maartenboz/ESP32-Room-Sensor-AI/bom/KiCad_MCP_Test_BOM.csv

References | Value | Footprint | Manufacturer | MPN | Datasheet | Description | Quantity
C1-C3,C5,C10,C12-C14 | 100n | Capacitor_SMD:C_0603_1608Metric | Yageo | CC0603KRX7R9BB104 | https://www.yageo.com/upload/media/product/productsearch/datasheet/mlcc/UPY-GPHC_X7R_6.3V-to-50V_18.pdf |  | 8
C4 | 10u | Capacitor_SMD:C_0805_2012Metric | Yageo | CC0805MKX5R5BB106 | https://www.yageo.com/upload/media/product/productsearch/datasheet/mlcc/UPY-GPHC_X7R_6.3V-to-50V_18.pdf |  | 1
C6 | 100n BST | Capacitor_SMD:C_0603_1608Metric | Yageo | CC0603KRX7R9BB104 | https://www.yageo.com/upload/media/product/productsearch/datasheet/mlcc/UPY-GPHC_X7R_6.3V-to-50V_18.pdf |  | 1
C7-C9 | 22u | Capacitor_SMD:C_0805_2012Metric | Murata | GRM21BR61A226ME44L | https://search.murata.co.jp/Ceramy/image/img/A01X/G101/ENG/GRM21BR61A226ME44-01.pdf |  | 3
C11 | 1u | Capacitor_SMD:C_0603_1608Metric | Yageo | CC0603KRX7R7BB105 | https://www.yageo.com/upload/media/product/productsearch/datasheet/mlcc/UPY-GPHC_X7R_6.3V-to-50V_18.pdf |  | 1
D1 | PESD5V0S1UL | Diode_SMD:D_SOD-882 | Nexperia | PESD5V0S1UL,315 | https://assets.nexperia.com/documents/data-sheet/PESD5V0S1UL.pdf |  | 1
D2 | USER_LED1 RED | LED_SMD:LED_0603_1608Metric | Kingbright | APT1608LSECK | https://www.kingbrightusa.com/images/catalog/SPEC/APT1608LSECK.pdf |  | 1
D3 | USER_LED2 YELLOW | LED_SMD:LED_0603_1608Metric | Kingbright | APT1608SYCK | https://www.kingbrightusa.com/images/catalog/SPEC/APT1608SYCK.pdf |  | 1
D4 | USB_RX GREEN | LED_SMD:LED_0603_1608Metric | Kingbright | APT1608SGC | https://www.kingbrightusa.com/images/catalog/SPEC/APT1608SGC.pdf |  | 1
D5 | USB_TX YELLOW | LED_SMD:LED_0603_1608Metric | Kingbright | APT1608SYCK | https://www.kingbrightusa.com/images/catalog/SPEC/APT1608SYCK.pdf |  | 1
D6 | PWR GREEN | LED_SMD:LED_0603_1608Metric | Kingbright | APT1608SGC | https://www.kingbrightusa.com/images/catalog/SPEC/APT1608SGC.pdf |  | 1
F1 | 1206L050/16WR | Fuse:Fuse_1206_3216Metric | Littelfuse | 1206L050/16WR | https://www.littelfuse.com/media?resourcetype=datasheets&itemid=6f07b5a6-cb36-452d-8a6c-93703eea1f9a |  | 1
J1 | USB4105-GF-A | Connector_USB:USB_C_Receptacle_GCT_USB4105-xx-A_16P_TopMnt_Horizontal | GCT | USB4105-GF-A | https://gct.co/connector/usb4105 |  | 1
L1 | 4.7uH XAL4020-472MEB | Inductor_SMD:L_Coilcraft_XAL4020-XXX | Coilcraft | XAL4020-472MEB | https://www.coilcraft.com/getmedia/78a676e0-1f2d-4e32-b142-5bcaab30da12/xal4020.pdf |  | 1
Q1,Q2 | MMBT3904LT1G | Package_TO_SOT_SMD:SOT-23 | onsemi | MMBT3904LT1G | https://www.onsemi.com/pdf/datasheet/mmbt3904lt1-d.pdf |  | 2
R1,R2 | 5.1k | Resistor_SMD:R_0603_1608Metric | Yageo | RC0603FR-075K1L | https://www.yageo.com/upload/media/product/productsearch/datasheet/rchip/PYu-RC_Group_51_RoHS_L_15.pdf |  | 2
R3-R5,R8-R10,R20 | 10k | Resistor_SMD:R_0603_1608Metric | Yageo | RC0603FR-0710KL | https://www.yageo.com/upload/media/product/productsearch/datasheet/rchip/PYu-RC_Group_51_RoHS_L_15.pdf |  | 7
R6,R7 | 0 | Resistor_SMD:R_0603_1608Metric | Yageo | RC0603JR-070RL | https://www.yageo.com/upload/media/product/productsearch/datasheet/rchip/PYu-RC_Group_51_RoHS_L_15.pdf |  | 2
R11,R12,R15 | 2.2k | Resistor_SMD:R_0603_1608Metric | Yageo | RC0603FR-072K2L | https://www.yageo.com/upload/media/product/productsearch/datasheet/rchip/PYu-RC_Group_51_RoHS_L_15.pdf |  | 3
R13,R14,R18,R19 | 1k | Resistor_SMD:R_0603_1608Metric | Yageo | RC0603FR-071KL | https://www.yageo.com/upload/media/product/productsearch/datasheet/rchip/PYu-RC_Group_51_RoHS_L_15.pdf |  | 4
R16,R17 | 4.7k | Resistor_SMD:R_0603_1608Metric | Yageo | RC0603FR-074K7L | https://www.yageo.com/upload/media/product/productsearch/datasheet/rchip/PYu-RC_Group_51_RoHS_L_15.pdf |  | 2
RV1,RV2 | 10k 3314J-1-103E | Potentiometer_SMD:Potentiometer_Bourns_3314J_Vertical | Bourns | 3314J-1-103E | https://www.bourns.com/docs/product-datasheets/3314.pdf |  | 2
SW1 | USER_BTN1 | Button_Switch_SMD:SW_Tactile_SPST_NO_Straight_CK_PTS636Sx25SMTRLFS | C&K | PTS636 SK25 SMTR LFS | https://www.ckswitches.com/media/1479/pts636.pdf |  | 1
SW2 | USER_BTN2 | Button_Switch_SMD:SW_Tactile_SPST_NO_Straight_CK_PTS636Sx25SMTRLFS | C&K | PTS636 SK25 SMTR LFS | https://www.ckswitches.com/media/1479/pts636.pdf |  | 1
SW3 | BOOT | Button_Switch_SMD:SW_Tactile_SPST_NO_Straight_CK_PTS636Sx25SMTRLFS | C&K | PTS636 SK25 SMTR LFS | https://www.ckswitches.com/media/1479/pts636.pdf |  | 1
SW4 | RESET | Button_Switch_SMD:SW_Tactile_SPST_NO_Straight_CK_PTS636Sx25SMTRLFS | C&K | PTS636 SK25 SMTR LFS | https://www.ckswitches.com/media/1479/pts636.pdf |  | 1
TP1 | 5V | TestPoint:TestPoint_Pad_D1.0mm | Keystone Electronics | 5015 |  |  | 1
TP2 | 3V3 | TestPoint:TestPoint_Pad_D1.0mm | Keystone Electronics | 5015 |  |  | 1
TP3 | GND | TestPoint:TestPoint_Pad_D1.0mm | Keystone Electronics | 5015 |  |  | 1
TP4 | TXD0 | TestPoint:TestPoint_Pad_D1.0mm | Keystone Electronics | 5015 |  |  | 1
TP5 | RXD0 | TestPoint:TestPoint_Pad_D1.0mm | Keystone Electronics | 5015 |  |  | 1
TP6 | EN | TestPoint:TestPoint_Pad_D1.0mm | Keystone Electronics | 5015 |  |  | 1
TP7 | GPIO0 | TestPoint:TestPoint_Pad_D1.0mm | Keystone Electronics | 5015 |  |  | 1
TP8 | SDA | TestPoint:TestPoint_Pad_D1.0mm | Keystone Electronics | 5015 |  |  | 1
TP9 | SCL | TestPoint:TestPoint_Pad_D1.0mm | Keystone Electronics | 5015 |  |  | 1
U1 | USBLC6-2SC6 | Package_TO_SOT_SMD:SOT-23-6 | STMicroelectronics | USBLC6-2SC6 | https://www.st.com/resource/en/datasheet/usblc6-2.pdf |  | 1
U2 | FT231XS-R | Package_SO:SSOP-20_3.9x8.7mm_P0.635mm | FTDI | FT231XS-R | https://ftdichip.com/wp-content/uploads/2021/10/DS_FT231X.pdf |  | 1
U3 | AP63203WU-7 | Package_TO_SOT_SMD:TSOT-23-6 | Diodes Incorporated | AP63203WU-7 | https://www.diodes.com/datasheet/download/AP63200-AP63201-AP63203-AP63205.pdf |  | 1
U4 | ESP32-S3-WROOM-1-N8 | RF_Module:ESP32-S3-WROOM-1 | Espressif Systems | ESP32-S3-WROOM-1-N8 | https://documentation.espressif.com/esp32-s3-wroom-1_wroom-1u_datasheet_en.pdf |  | 1
U5 | SHT40-AD1B-R2 | Sensor_Humidity:Sensirion_DFN-4_1.5x1.5mm_P0.8mm_SHT4x_NoCentralPad | Sensirion | SHT40-AD1B-R2 | https://sensirion.com/media/documents/33FD6951/67EB9032/HT_DS_Datasheet_SHT4x.pdf |  | 1
