maartenboz/ESP32-Room-Sensor-AI/docs/pdf/ESP32-Room-Sensor-Schematic.pdf

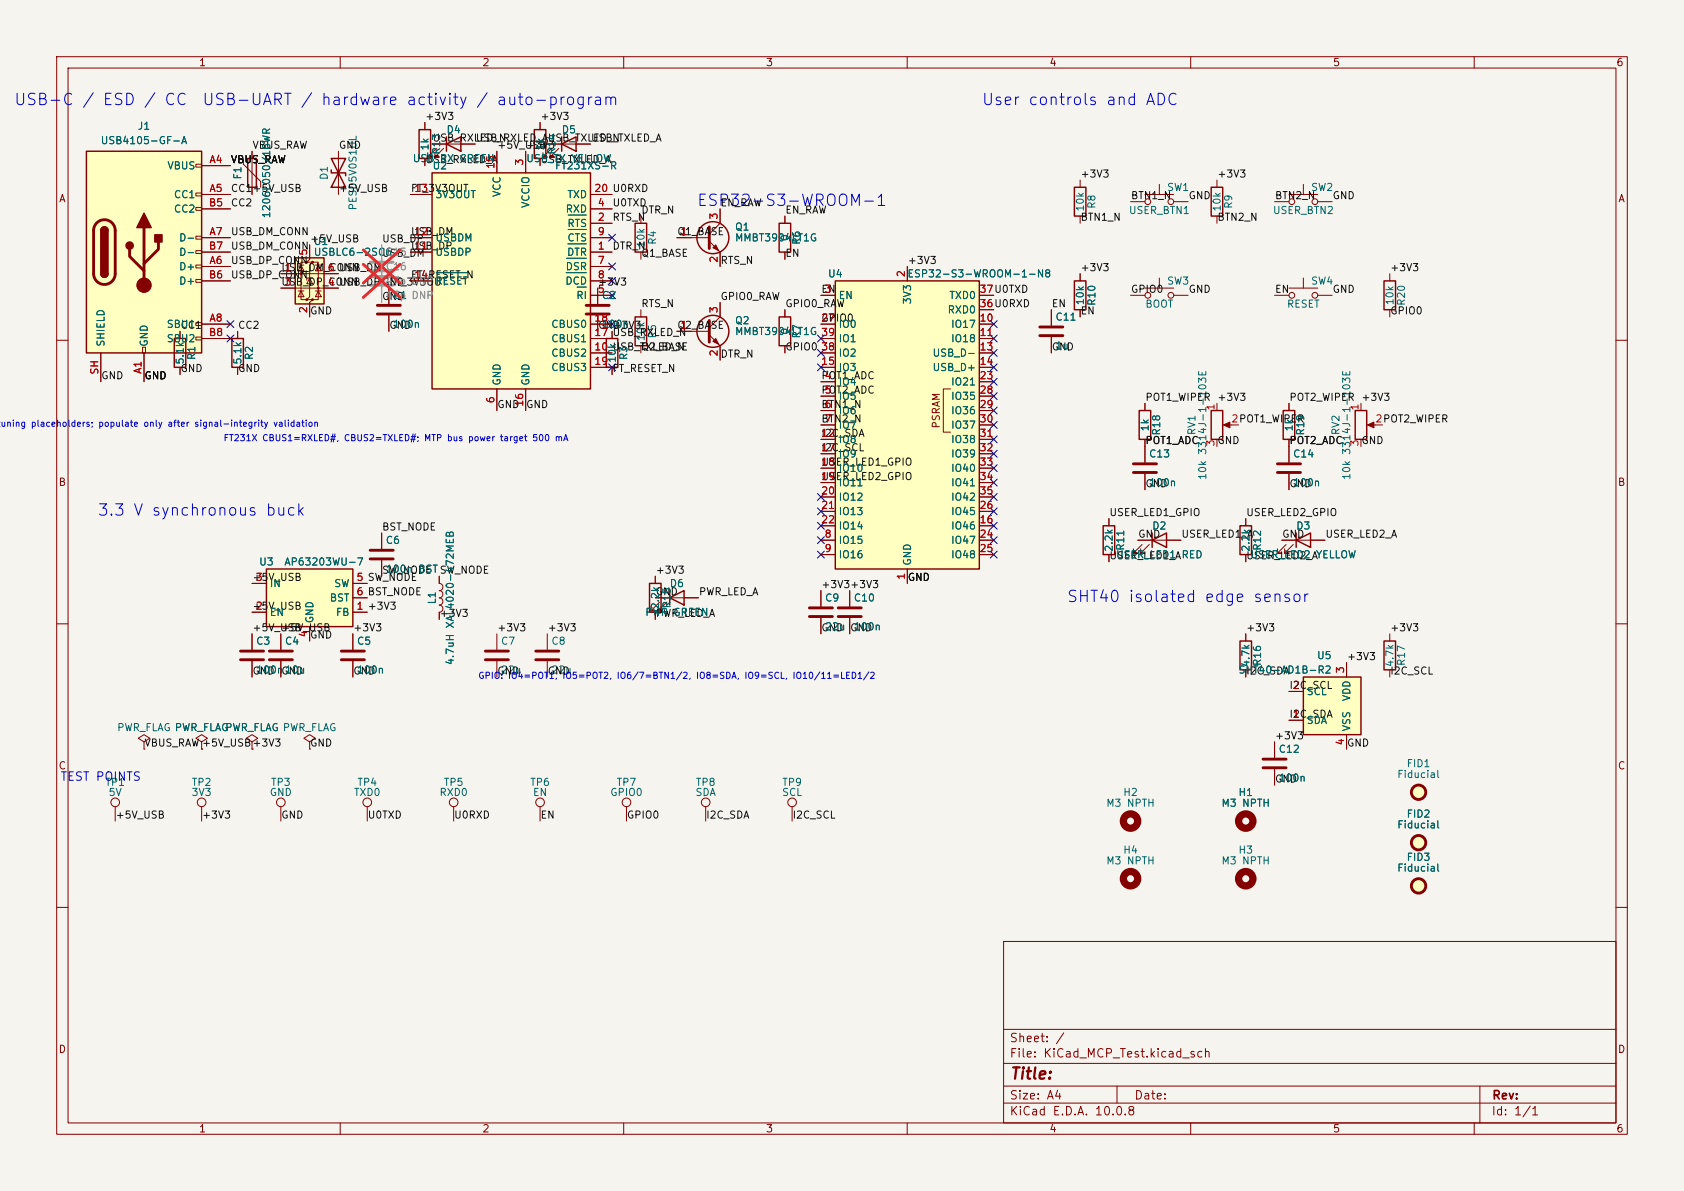
[picture p4: page 1]

GPIO: IO4=POT1, IO5=POT2, IO6/7=BTN1/2, IO8=SDA, IO9=SCL, IO10/11=LED1/2 USB-UART / hardware activity / auto-program

6 DSR 7 DCD 8 CTS 9 CBUS2 10 USBDP 11 USBDM 12

C15/C16 are DNP USB tuning placeholders; populate only after signal-integrity validation

Size: A4 | Rev:
KiCad E.D.A. 10.0.8 | Id: 1/1
