maartenboz/ESP32-Room-Sensor-AI/docs/pdf/ESP32-Room-Sensor-PCB.pdf

L1 | USB-C
RX | TX | PWR

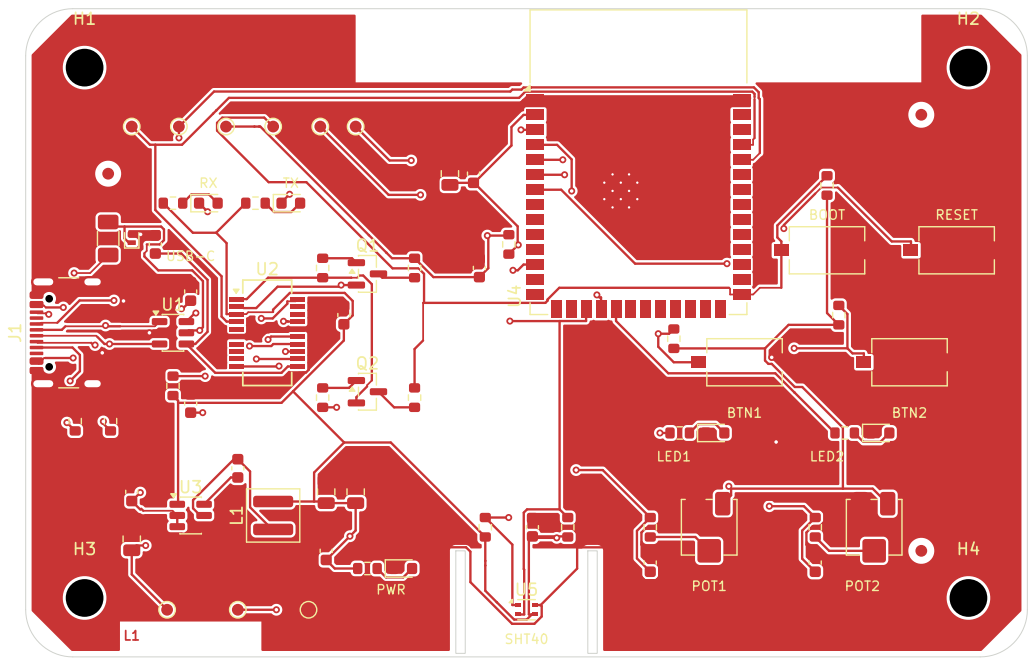
[picture p5: page 1]
SHT40; LED1POT1BTN1; BOOT LED2POT2 BTN2 RESET Q1Q2 J1

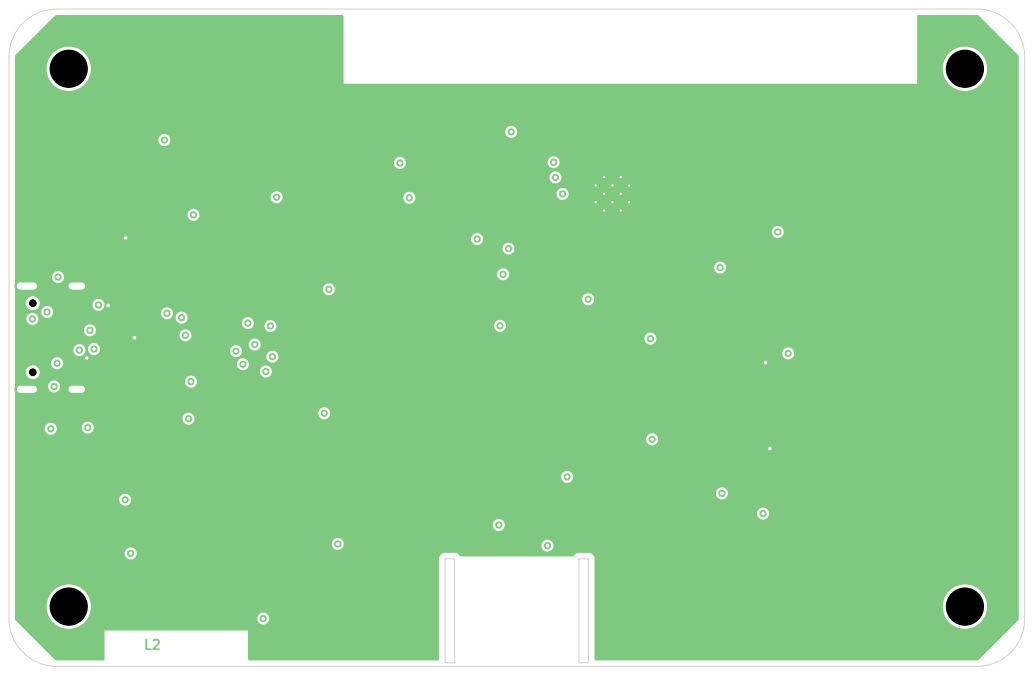
[picture p6: page 2]

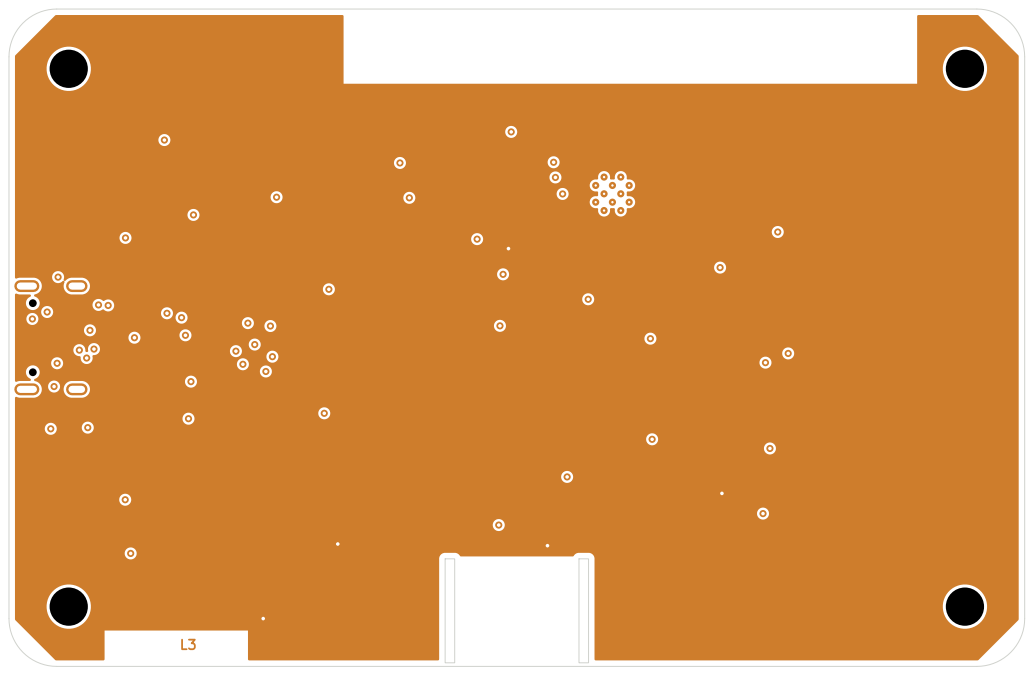
[picture p7: page 3]

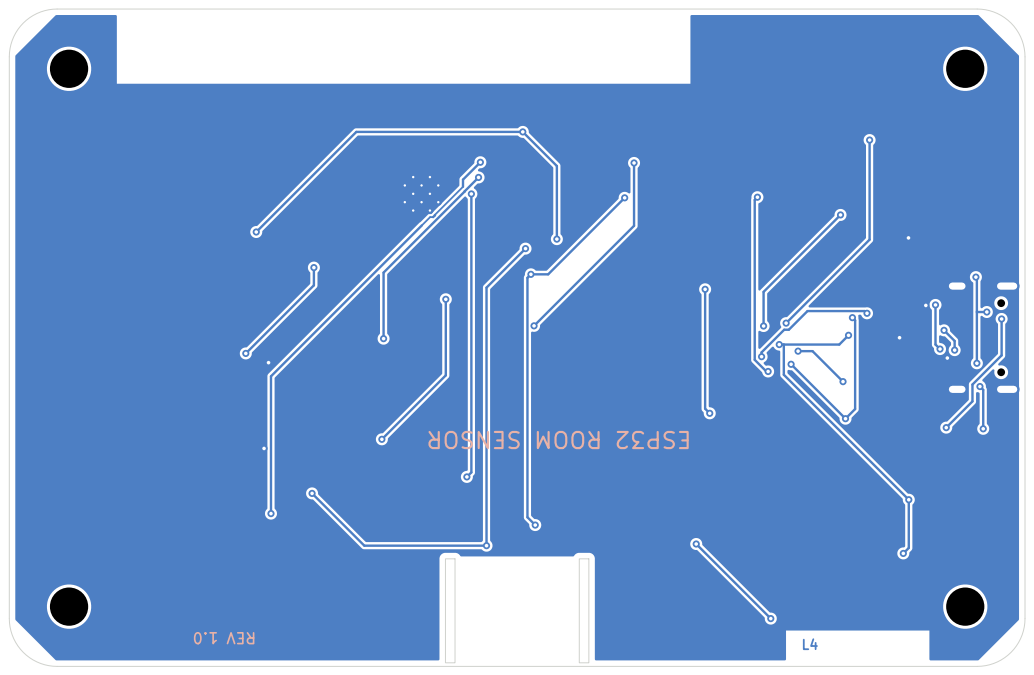
[picture p8: page 4]
REV; SENSOR; ROOM; ESP32
