maartenboz/ESP32-Room-Sensor-AI/KiCad_MCP_Test.kicad_pcb

## KiCad design KiCad_MCP_Test.kicad_pcb (2026-11-09)

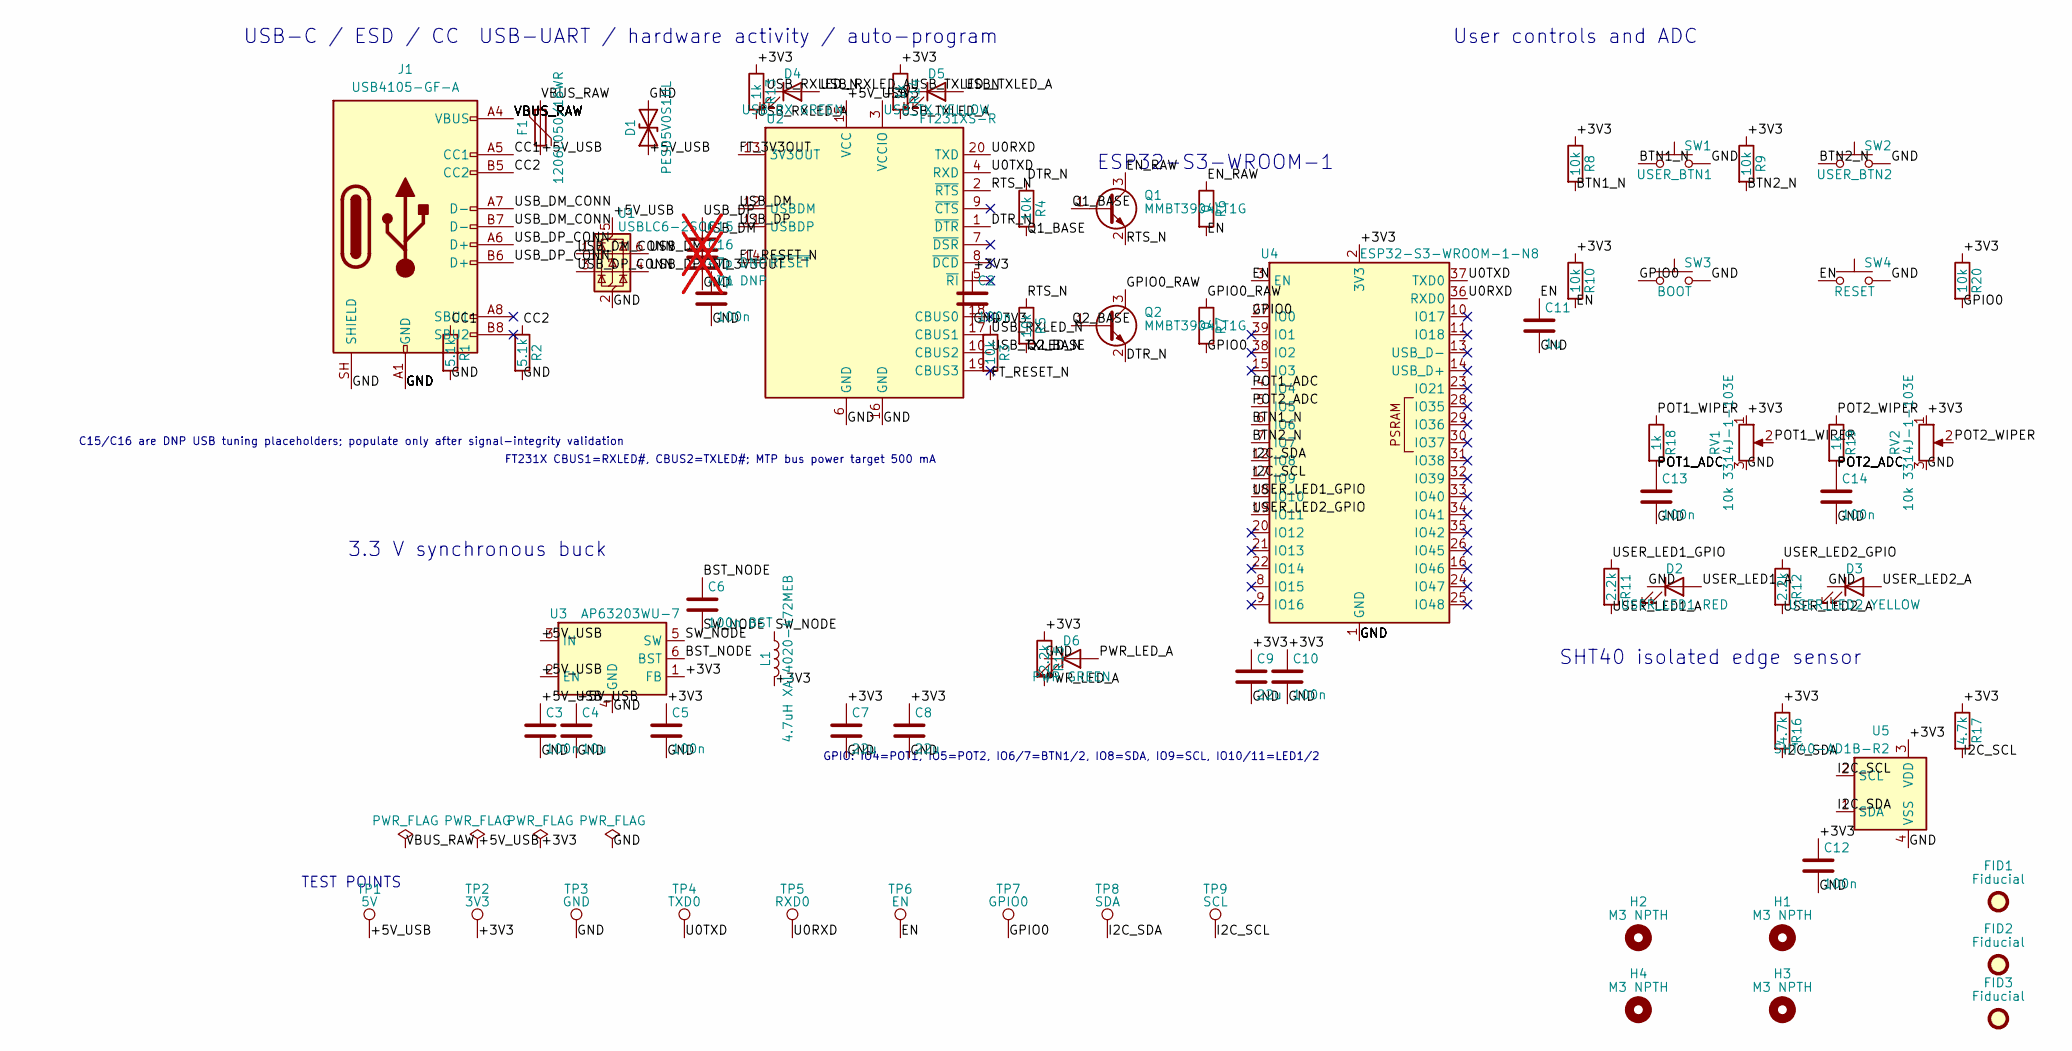
[picture p9: schematic KiCad_MCP_Test.kicad_sch]

Parts:
C1, C2, C3, C5, C10, C12, C13, C14: 100n; C_0603_1608Metric; Manufacturer Part Number CC0603KRX7R9BB104
C4: 10u; C_0805_2012Metric; Manufacturer Part Number CC0805MKX5R5BB106
C6: 100n BST; C_0603_1608Metric; Manufacturer Part Number CC0603KRX7R9BB104
C7, C8, C9: 22u; C_0805_2012Metric; Manufacturer Part Number GRM21BR61A226ME44L
C11: 1u; C_0603_1608Metric; Manufacturer Part Number CC0603KRX7R7BB105
C15, C16: 47p DNP; C_0603_1608Metric; Manufacturer Part Number CC0603JRNPO9BN470; not fitted
D1: PESD5V0S1UL; D_SOD-882; Manufacturer Part Number PESD5V0S1UL,315
D2: USER_LED1 RED; LED_0603_1608Metric; Manufacturer Part Number APT1608LSECK
D3: USER_LED2 YELLOW; LED_0603_1608Metric; Manufacturer Part Number APT1608SYCK
D4: USB_RX GREEN; LED_0603_1608Metric; Manufacturer Part Number APT1608SGC
D5: USB_TX YELLOW; LED_0603_1608Metric; Manufacturer Part Number APT1608SYCK
D6: PWR GREEN; LED_0603_1608Metric; Manufacturer Part Number APT1608SGC
F1: 1206L050/16WR; Fuse_1206_3216Metric; Manufacturer Part Number 1206L050/16WR
FID1, FID2, FID3: Fiducial; Fiducial_1mm_Mask2mm
H1, H2, H3, H4: M3 NPTH; MountingHole_3.2mm_M3
J1: USB4105-GF-A; USB_C_Receptacle_GCT_USB4105-xx-A_16P_TopMnt_Horizontal; Manufacturer Part Number USB4105-GF-A
L1: 4.7uH XAL4020-472MEB; L_Coilcraft_XAL4020-XXX; Manufacturer Part Number XAL4020-472MEB
Q1, Q2: MMBT3904LT1G; SOT-23; Manufacturer Part Number MMBT3904LT1G
R1, R2: 5.1k; R_0603_1608Metric; Manufacturer Part Number RC0603FR-075K1L
R3, R4, R5, R8, R9, R10, R20: 10k; R_0603_1608Metric; Manufacturer Part Number RC0603FR-0710KL
R6, R7: 0; R_0603_1608Metric; Manufacturer Part Number RC0603JR-070RL
R11, R12, R15: 2.2k; R_0603_1608Metric; Manufacturer Part Number RC0603FR-072K2L
R13, R14, R18, R19: 1k; R_0603_1608Metric; Manufacturer Part Number RC0603FR-071KL
R16, R17: 4.7k; R_0603_1608Metric; Manufacturer Part Number RC0603FR-074K7L
RV1, RV2: 10k 3314J-1-103E; Potentiometer_Bourns_3314J_Vertical; Manufacturer Part Number 3314J-1-103E
SW1: USER_BTN1; SW_Tactile_SPST_NO_Straight_CK_PTS636Sx25SMTRLFS; Manufacturer Part Number PTS636 SK25 SMTR LFS
SW2: USER_BTN2; SW_Tactile_SPST_NO_Straight_CK_PTS636Sx25SMTRLFS; Manufacturer Part Number PTS636 SK25 SMTR LFS
SW3: BOOT; SW_Tactile_SPST_NO_Straight_CK_PTS636Sx25SMTRLFS; Manufacturer Part Number PTS636 SK25 SMTR LFS
SW4: RESET; SW_Tactile_SPST_NO_Straight_CK_PTS636Sx25SMTRLFS; Manufacturer Part Number PTS636 SK25 SMTR LFS
TP1: 5V; TestPoint_Pad_D1.0mm; Manufacturer Part Number 5015
TP2: 3V3; TestPoint_Pad_D1.0mm; Manufacturer Part Number 5015
TP3: GND; TestPoint_Pad_D1.0mm; Manufacturer Part Number 5015
TP4: TXD0; TestPoint_Pad_D1.0mm; Manufacturer Part Number 5015
TP5: RXD0; TestPoint_Pad_D1.0mm; Manufacturer Part Number 5015
TP6: EN; TestPoint_Pad_D1.0mm; Manufacturer Part Number 5015
TP7: GPIO0; TestPoint_Pad_D1.0mm; Manufacturer Part Number 5015
TP8: SDA; TestPoint_Pad_D1.0mm; Manufacturer Part Number 5015
TP9: SCL; TestPoint_Pad_D1.0mm; Manufacturer Part Number 5015
U1: USBLC6-2SC6; SOT-23-6; Manufacturer Part Number USBLC6-2SC6
U2: FT231XS-R; SSOP-20_3.9x8.7mm_P0.635mm; Manufacturer Part Number FT231XS-R
U3: AP63203WU-7; TSOT-23-6; Manufacturer Part Number AP63203WU-7
U4: ESP32-S3-WROOM-1-N8; ESP32-S3-WROOM-1; Manufacturer Part Number ESP32-S3-WROOM-1-N8
U5: SHT40-AD1B-R2; Sensirion_DFN-4_1.5x1.5mm_P0.8mm_SHT4x_NoCentralPad; Manufacturer Part Number SHT40-AD1B-R2

Connections:
/+3V3: C2.1, C5.1, C7.1, C8.1, C9.1, C10.1, C12.1, L1.2, R3.1, R8.1, R9.1, R10.1, R13.1, R14.1, R15.1, R16.1, R17.1, R20.1, RV1.1, RV2.1, TP2.1, U2.3 (VCCIO), U3.1 (FB), U4.2 (3V3), U5.3 (VDD)
/+5V_USB: C3.1, C4.1, D1.1 (A1), F1.2, TP1.1, U1.5 (VBUS), U2.15 (VCC), U3.2 (EN), U3.3 (IN)
/BST_NODE: C6.1, U3.6 (BST)
/BTN1_N: R8.2, SW1.1, U4.6 (IO6)
/BTN2_N: R9.2, SW2.1, U4.7 (IO7)
/CC1: J1.A5 (CC1), R1.1
/CC2: J1.B5 (CC2), R2.1
/DTR_N: Q2.2 (E), R4.1, U2.1 (~DTR)
/EN: C11.1, R6.2, R10.2, SW4.1, TP6.1, U4.3 (EN)
/EN_RAW: Q1.3 (C), R6.1
/FT_3V3OUT: C1.1, U2.13 (3V3OUT)
/FT_RESET_N: R3.2, U2.14 (~RESET)
/GND: C1.2, C2.2, C3.2, C4.2, C5.2, C7.2, C8.2, C9.2, C10.2, C11.2, C12.2, C13.2, C14.2, C15.2, C16.2, D1.2 (A2), D2.1 (K), D3.1 (K), D6.1 (K), J1.A1 (GND), J1.A12 (GND), J1.B1 (GND), J1.B12 (GND), J1.SH (SHIELD), R1.2, R2.2, RV1.3, RV2.3, SW1.2, SW2.2, SW3.2, SW4.2, TP3.1, U1.2 (GND), U2.6 (GND), U2.16 (GND), U3.4 (GND), U4.1 (GND), U4.40 (GND), U4.41 (GND), U5.4 (VSS)
/GPIO0: R7.2, R20.2, SW3.1, TP7.1, U4.27 (IO0)
/GPIO0_RAW: Q2.3 (C), R7.1
/I2C_SCL: R17.2, TP9.1, U4.17 (IO9), U5.2 (SCL)
/I2C_SDA: R16.2, TP8.1, U4.12 (IO8), U5.1 (SDA)
/POT1_ADC: C13.1, R18.2, U4.4 (IO4)
/POT1_WIPER: R18.1, RV1.2
/POT2_ADC: C14.1, R19.2, U4.5 (IO5)
/POT2_WIPER: R19.1, RV2.2
/PWR_LED_A: D6.2 (A), R15.2
/Q1_BASE: Q1.1 (B), R4.2
/Q2_BASE: Q2.1 (B), R5.2
/RTS_N: Q1.2 (E), R5.1, U2.2 (~RTS)
/SW_NODE: C6.2, L1.1, U3.5 (SW)
/U0RXD: TP5.1, U2.20 (TXD), U4.36 (RXD0)
/U0TXD: TP4.1, U2.4 (RXD), U4.37 (TXD0)
/USB_DM: C16.1, U1.6 (I/O1), U2.12 (USBDM)
/USB_DM_CONN: J1.A7 (D-), J1.B7 (D-), U1.1 (I/O1)
/USB_DP: C15.1, U1.4 (I/O2), U2.11 (USBDP)
/USB_DP_CONN: J1.A6 (D+), J1.B6 (D+), U1.3 (I/O2)
/USB_RXLED_A: D4.2 (A), R13.2
/USB_RXLED_N: D4.1 (K), U2.17 (CBUS1)
/USB_TXLED_A: D5.2 (A), R14.2
/USB_TXLED_N: D5.1 (K), U2.10 (CBUS2)
/USER_LED1_A: D2.2 (A), R11.2
/USER_LED1_GPIO: R11.1, U4.18 (IO10)
/USER_LED2_A: D3.2 (A), R12.2
/USER_LED2_GPIO: R12.1, U4.19 (IO11)
/VBUS_RAW: F1.1, J1.A4 (VBUS), J1.A9 (VBUS), J1.B4 (VBUS), J1.B9 (VBUS)

Notes on the sheet:
USB-C / ESD / CC
USB-UART / hardware activity / auto-program
3.3 V synchronous buck
ESP32-S3-WROOM-1
User controls and ADC
SHT40 isolated edge sensor
TEST POINTS
GPIO: IO4=POT1, IO5=POT2, IO6/7=BTN1/2, IO8=SDA, IO9=SCL, IO10/11=LED1/2
FT231X CBUS1=RXLED#, CBUS2=TXLED#; MTP bus power target 500 mA
C15/C16 are DNP USB tuning placeholders; populate only after signal-integrity validation

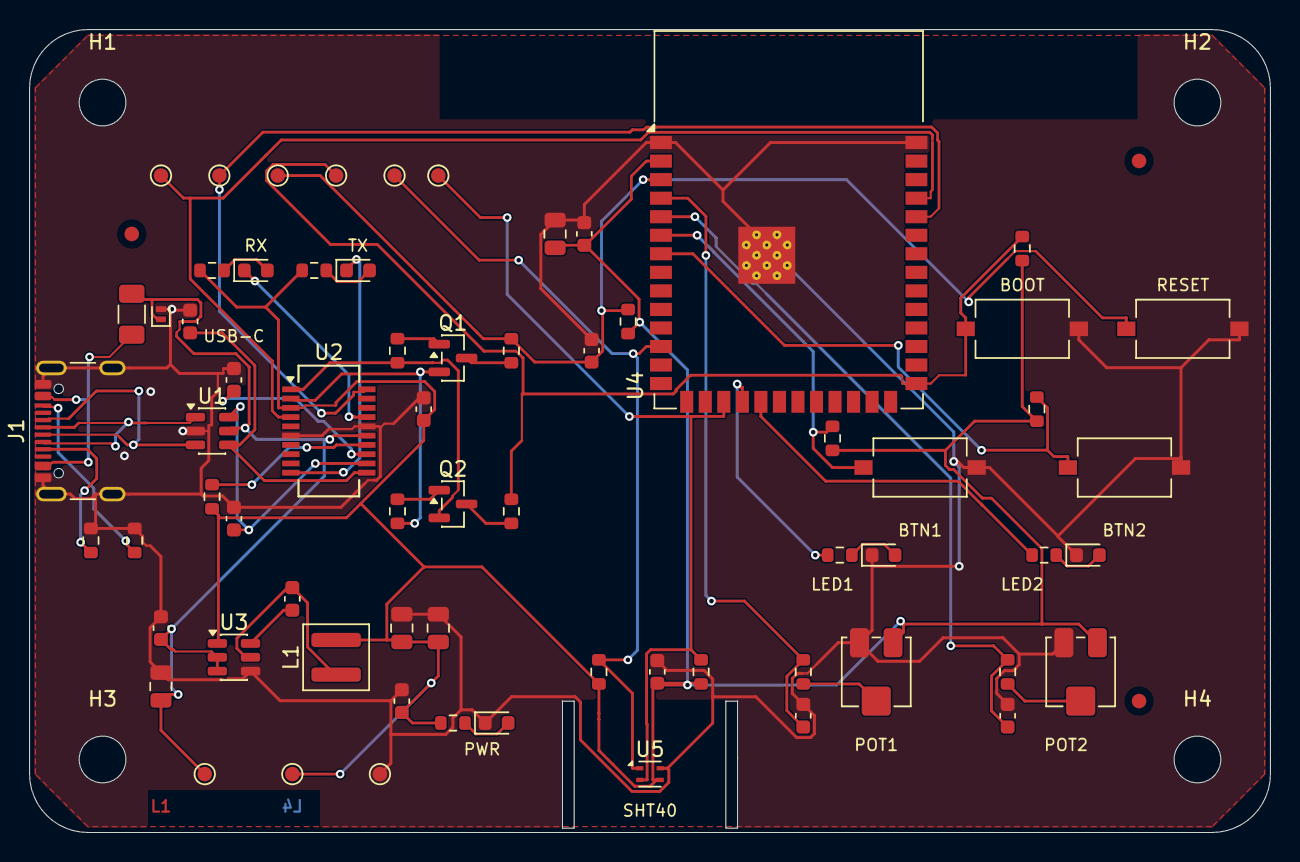
[picture p10: board KiCad_MCP_Test.kicad_pcb from above]

Board: 4 copper layers, 85.0 x 55.0 mm, 74 parts (0 on the bottom side), 41 nets.
