maartenboz/ESP32-Room-Sensor-AI/(commit log)

2026-11-09 Initial release of ESP32 Room Sensor PCB
    [KiCad_MCP_Test.kicad_pcb, KiCad_MCP_Test.kicad_sch, KiCad_MCP_Test_BOM.csv]
2026-11-09 Document AI-driven KiCad experiment
